tienduy127/Speaker_Circuit/README.md

# Speaker_Circuit
Mô phỏng mạch khuếch đại âm thanh qua loa bằng Proteus. Thiết kế, phân tích và kiểm tra hoạt động khuếch đại tín hiệu âm thanh.
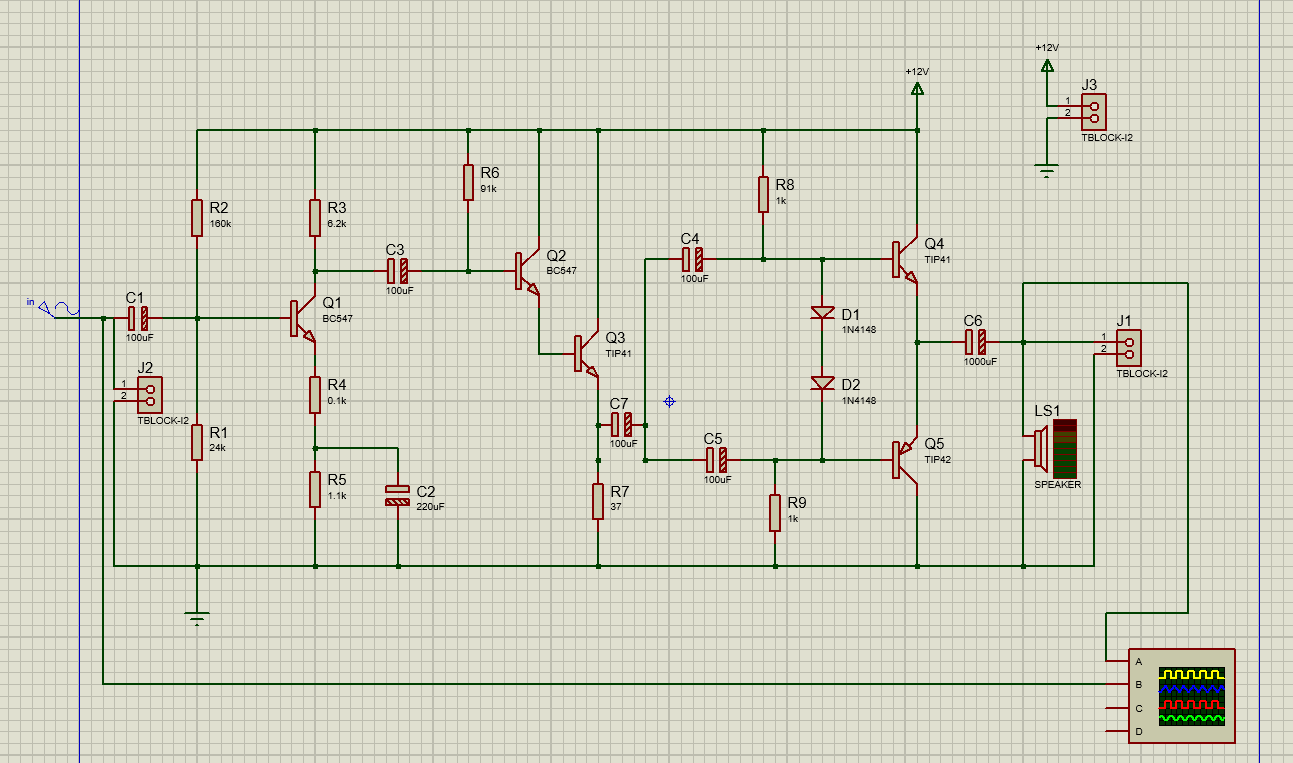
[picture p1: loa.png]
