tienduy127/Speaker_Circuit/(list of files, drawings)

Other design files:
Rp.pdsprj
Rp_coloa.pdsprj
